tilchl/gaggimate/stls/pcb/gaggimate-pro-rev1/pcb_cover_clipped_[support].stl

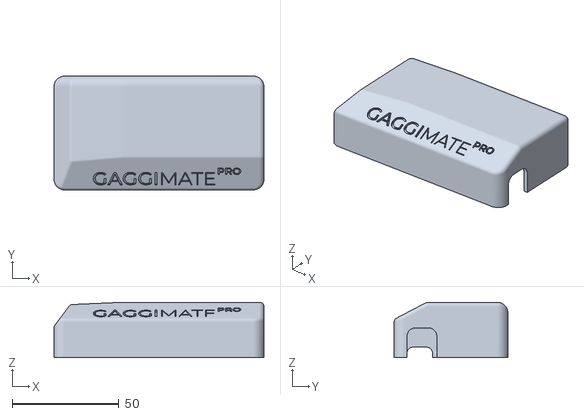
[picture p1: CAD file, 2025-05-01]
stls/pcb/gaggimate-pro-rev1/pcb_cover_clipped_[support].stl
98.4 x 53.4 x 26.0
