tilchl/gaggimate/stls/pcb/gaggimate-standard-rev2/pcb_cover_clipped_[support].stl

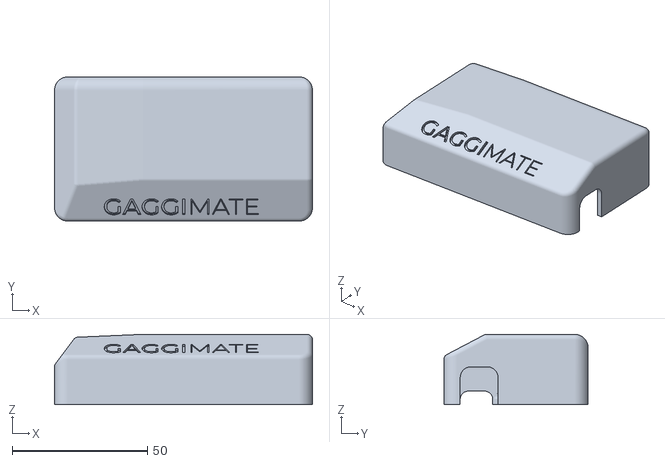
[picture p2: CAD file, 2025-05-01]
stls/pcb/gaggimate-standard-rev2/pcb_cover_clipped_[support].stl
95.4 x 53.4 x 26.0
