tilchl/gaggimate/stls/pcb/gaggimate-pro-rev1/pcb_base_clipped.stl

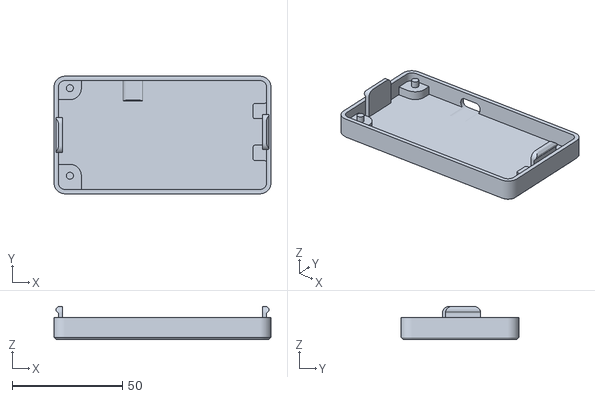
[picture p3: CAD file, 2025-05-01]
stls/pcb/gaggimate-pro-rev1/pcb_base_clipped.stl
98.4 x 53.4 x 15.0
