tilchl/gaggimate/stls/pcb/gaggimate-standard-rev2/pcb_base_clipped.stl

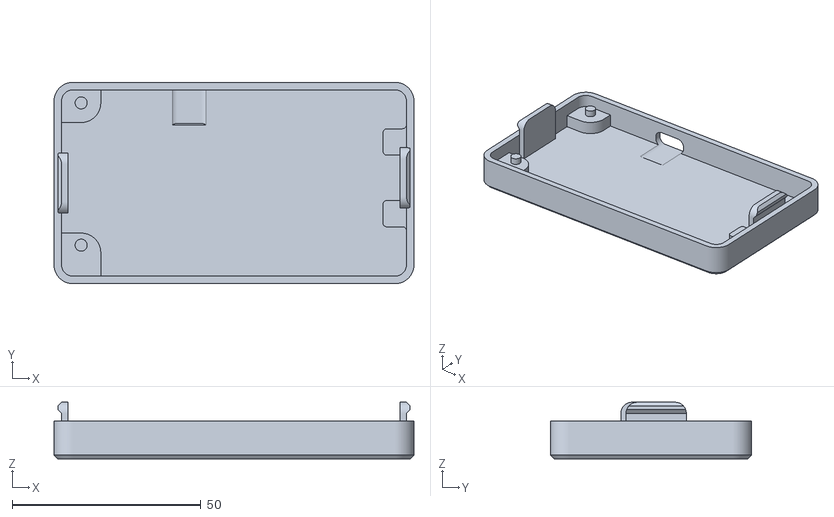
[picture p4: CAD file, 2025-05-01]
stls/pcb/gaggimate-standard-rev2/pcb_base_clipped.stl
95.4 x 53.4 x 15.0
