tilchl/gaggimate/src/display/core/Settings.h

#ifndef SETTINGS_H
#define SETTINGS_H

#include "constants.h"

#include <Arduino.h>
#include <Preferences.h>

#define PREFERENCES_KEY "controller"

class Settings;
using SettingsCallback = std::function<void(Settings *)>;

class Settings {
  public:
    Settings();

    void batchUpdate(const SettingsCallback &callback);
    void save();

    // Getters and setters
    int getTargetBrewTemp() const { return targetBrewTemp; }
    int getTargetSteamTemp() const { return targetSteamTemp; }
    int getTargetWaterTemp() const { return targetWaterTemp; }
    int getTemperatureOffset() const { return temperatureOffset; }
    int getTargetDuration() const { return targetDuration; }
    int getTargetVolume() const { return targetVolume; }
    int getTargetGrindVolume() const { return targetGrindVolume; }
    int getTargetGrindDuration() const { return targetGrindDuration; }
    int getStartupMode() const { return startupMode; }
    int getStandbyTimeout() const { return standbyTimeout; }
    int getInfuseBloomTime() const { return infuseBloomTime; }
    int getInfusePumpTime() const { return infusePumpTime; }
    int getPressurizeTime() const { return pressurizeTime; }
    double getBrewDelay() const { return brewDelay; }
    double getGrindDelay() const { return grindDelay; }
    bool isDelayAdjust() const { return delayAdjust; }
    String getPid() const { return pid; }
    String getWifiSsid() const { return wifiSsid; }
    String getWifiPassword() const { return wifiPassword; }
    String getMdnsName() const { return mdnsName; }
    bool isHomekit() const { return homekit; }
    bool isVolumetricTarget() const { return volumetricTarget; }
    String getOTAChannel() const { return otaChannel; }
    String getSavedScale() const { return savedScale; }
    bool isBoilerFillActive() const { return boilerFillActive; }
    int getStartupFillTime() const { return startupFillTime; }
    int getSteamFillTime() const { return steamFillTime; }
    bool isSmartGrindActive() const { return smartGrindActive; }
    int getSmartGrindMode() const { return smartGrindMode; }
    String getSmartGrindIp() const { return smartGrindIp; }
    bool isHomeAssistant() const { return homeAssistant; }
    String getHomeAssistantIP() const { return homeAssistantIP; }
    String getHomeAssistantUser() const { return homeAssistantUser; }
    String getHomeAssistantPassword() const { return homeAssistantPassword; }
    int getHomeAssistantPort() const { return homeAssistantPort; }
    bool isMomentaryButtons() const { return momentaryButtons; }
    String getTimezone() const { return timezone; }
    void setTargetBrewTemp(int target_brew_temp);
    void setTargetSteamTemp(int target_steam_temp);
    void setTargetWaterTemp(int target_water_temp);
    void setTemperatureOffset(int temperature_offset);
    void setTargetDuration(int target_duration);
    void setTargetVolume(int target_volume);
    void setTargetGrindVolume(int target_grind_volume);
    void setTargetGrindDuration(int target_duration);
    void setStartupMode(int startup_mode);
    void setStandbyTimeout(int standby_timeout);
    void setInfuseBloomTime(int infuse_bloom_time);
    void setInfusePumpTime(int infuse_pump_time);
    void setPressurizeTime(int pressurize_time);
    void setBrewDelay(double brewDelay);
    void setGrindDelay(double grindDelay);
    void setDelayAdjust(bool delay_adjust);
    void setPid(const String &pid);
    void setWifiSsid(const String &wifiSsid);
    void setWifiPassword(const String &wifiPassword);
    void setMdnsName(const String &mdnsName);
    void setHomekit(bool homekit);
    void setVolumetricTarget(bool volumetric_target);
    void setOTAChannel(const String &otaChannel);
    void setSavedScale(const String &savedScale);
    void setBoilerFillActive(bool boiler_fill_active);
    void setStartupFillTime(int startup_fill_time);
    void setSteamFillTime(int steam_fill_time);
    void setSmartGrindActive(bool smart_grind_active);
    void setSmartGrindIp(String smart_grind_ip);
    void setSmartGrindMode(int smart_grind_mode);
    void setHomeAssistant(bool homeAssistant);
    void setHomeAssistantUser(const String &homeAssistantUser);
    void setHomeAssistantPassword(const String &homeAssistantPassword);
    void setHomeAssistantIP(const String &homeAssistantIP);
    void setHomeAssistantPort(int homeAssistantPort);
    void setMomentaryButtons(bool momentary_buttons);
    void setTimezone(String timezone);

  private:
    Preferences preferences;
    bool dirty = false;

    int targetBrewTemp = 93;
    int targetSteamTemp = 155;
    int targetWaterTemp = 80;
    int temperatureOffset = DEFAULT_TEMPERATURE_OFFSET;
    int targetDuration = 25000;
    int targetVolume = 36;
    int targetGrindVolume = 18;
    int targetGrindDuration = 25000;
    double brewDelay = 1000.0;
    double grindDelay = 1000.0;
    bool delayAdjust = true;
    int startupMode = MODE_STANDBY;
    int standbyTimeout = DEFAULT_STANDBY_TIMEOUT_MS;
    int infuseBloomTime = 0;
    int infusePumpTime = 0;
    int pressurizeTime = 0;
    String pid = DEFAULT_PID;
    String wifiSsid = "";
    String wifiPassword = "";
    String mdnsName = DEFAULT_MDNS_NAME;
    String savedScale = "";
    bool homekit = false;
    bool volumetricTarget = false;
    bool boilerFillActive = false;
    int startupFillTime = 0;
    int steamFillTime = 0;
    bool smartGrindActive = false;
    bool smartGrindToggle = false;
    int smartGrindMode = 0;
    String smartGrindIp = "";
    bool homeAssistant = false;
    String homeAssistantUser = "";
    String homeAssistantPassword = "";
    String homeAssistantIP = "";
    int homeAssistantPort = 1883;
    bool momentaryButtons = false;
    String timezone = DEFAULT_TIMEZONE;

    String otaChannel = DEFAULT_OTA_CHANNEL;

    void doSave();
    xTaskHandle taskHandle;
    static void loopTask(void *arg);
};

#endif // SETTINGS_H
