tilchl/gaggimate/src/display/ui/default/DefaultUI.h

#ifndef DEFAULTUI_H
#define DEFAULTUI_H

#include <display/core/PluginManager.h>
#include <display/core/constants.h>

#include "./lvgl/ui.h"

class Controller;

constexpr int RERENDER_INTERVAL_IDLE = 2500;
constexpr int RERENDER_INTERVAL_ACTIVE = 250;

int16_t calculate_angle(int set_temp);

class DefaultUI {
  public:
    DefaultUI(Controller *controller, PluginManager *pluginManager);

    // Default work methods
    void init();
    void loop();

    // Interface methods
    void changeScreen(lv_obj_t **screen, void (*target_init)(void));

  private:
    void setupPanel() const;
    void setupState();
    void setupReactive();

    void handleScreenChange();

    void updateStandbyScreen() const;
    void updateStatusScreen() const;

    Controller *controller;
    PluginManager *pluginManager;

    // Screen state
    int updateAvailable = false;
    int updateActive = false;
    int apActive = false;
    int error = false;
    int autotuning = false;
    int volumetricAvailable = false;
    int volumetricMode = false;
    int grindActive = false;
    int active = false;

    bool rerender = false;
    unsigned long lastRender = 0;

    int mode = MODE_STANDBY;
    int currentTemp = 0;
    int targetTemp = 0;
    int targetDuration = 0;
    int targetVolume = 0;
    int grindDuration = 0;
    int grindVolume = 0;

    // Screen change
    lv_obj_t **targetScreen = &ui_InitScreen;
    lv_obj_t *currentScreen = ui_InitScreen;
    void (*targetScreenInit)(void) = &ui_InitScreen_screen_init;

    xTaskHandle taskHandle;
    static void loopTask(void *arg);
};

#endif // DEFAULTUI_H
