tilchl/gaggimate/(commit log)

2024-11-20 Update Kiri output for PR #26
    [Gaggimate.kicad_pcb, Gaggimate.kicad_sch, gaggimate-expansion-template.kicad_pcb, gaggimate-expansion-template.kicad_sch]
2024-11-20 fix: Remove kiri files
    [Gaggimate.kicad_pcb, Gaggimate.kicad_sch, gaggimate-expansion-template.kicad_pcb, gaggimate-expansion-template.kicad_sch]
2024-11-23 Update Kiri output for PR #31
    [Gaggimate.kicad_pcb, Gaggimate.kicad_sch, diff.txt, gaggimate-expansion-template.kicad_pcb, gaggimate-expansion-template.kicad_sch]
2024-11-24 Update Kiri output for PR #33
    [Gaggimate.kicad_pcb, Gaggimate.kicad_sch, diff.txt, gaggimate-expansion-template.kicad_pcb, gaggimate-expansion-template.kicad_sch]
2024-12-12 Add new variant for pcb gen 2
    [Gaggimate.kicad_pcb, Gaggimate.kicad_sch]
2025-04-06 feat: Fix pressing through wakeup, adjust button borders
    [WebUIPlugin.cpp]
